Tinman-FP/sovol-sv08-max/c3-4040-gantry/c3/C3_BOM.md

# C3 BOM (AWD 4040 gantry, SV08 Max, INDX, top hat)

## Printed (Qidi Plus 4; PPS-CF unless noted, top hat in ASA)

| Part | Qty | Material | File | Volume cm3 (each) | Mass g (each) | Print size mm |
|---|---|---|---|---|---|---|
| x carriage | 1 | PPS-CF | X_CARRIAGE_PPS-CF.stl | 42.1 | 55 | 80.0 x 39.1 x 88.8 |
| xy joint plate xn | 1 | PPS-CF | XY_JOINT_PLATE_XN_PPS-CF.stl | 30.9 | 40 | 92.5 x 39.0 x 35.0 |
| xy joint plate xp | 1 | PPS-CF | XY_JOINT_PLATE_XP_PPS-CF.stl | 30.9 | 40 | 92.5 x 39.0 x 35.0 |
| xy joint pulley carrier xn | 1 | PPS-CF | XY_JOINT_PULLEY_CARRIER_XN_PPS-CF.stl | 16.4 | 21 | 45.0 x 54.0 x 29.0 |
| xy joint pulley carrier xp | 1 | PPS-CF | XY_JOINT_PULLEY_CARRIER_XP_PPS-CF.stl | 16.4 | 21 | 45.0 x 54.0 x 29.0 |
| rear corner xn motor mount | 1 | PPS-CF | REAR_CORNER_XN_MOTOR_MOUNT_PPS-CF.stl | 55.5 | 72 | 128.0 x 70.0 x 41.0 |
| rear corner xn bearing cap | 1 | PPS-CF | REAR_CORNER_XN_BEARING_CAP_PPS-CF.stl | 36.8 | 48 | 113.0 x 49.6 x 49.0 |
| rear shaft cover xn | 1 | PPS-CF | REAR_SHAFT_COVER_XN_PPS-CF.stl | 2.3 | 3 | 12.0 x 12.0 x 29.0 |
| front corner base xn | 1 | PPS-CF | FRONT_CORNER_BASE_XN_PPS-CF.stl | 17.9 | 23 | 65.0 x 56.0 x 24.8 |
| front cradle xn | 1 | PPS-CF | FRONT_CRADLE_XN_PPS-CF.stl | 66.7 | 87 | 57.5 x 91.5 x 61.0 |
| front motor slider xn | 1 | PPS-CF | FRONT_MOTOR_SLIDER_XN_PPS-CF.stl | 31.2 | 41 | 57.5 x 49.0 x 82.0 |
| rear corner xp motor mount | 1 | PPS-CF | REAR_CORNER_XP_MOTOR_MOUNT_PPS-CF.stl | 49.8 | 65 | 128.0 x 70.0 x 39.0 |
| rear corner xp bearing cap | 1 | PPS-CF | REAR_CORNER_XP_BEARING_CAP_PPS-CF.stl | 21.9 | 28 | 113.0 x 49.6 x 44.0 |
| rear shaft cover xp | 1 | PPS-CF | REAR_SHAFT_COVER_XP_PPS-CF.stl | 2.8 | 4 | 12.0 x 12.0 x 34.0 |
| front corner base xp | 1 | PPS-CF | FRONT_CORNER_BASE_XP_PPS-CF.stl | 17.9 | 23 | 65.0 x 56.0 x 24.8 |
| front cradle xp | 1 | PPS-CF | FRONT_CRADLE_XP_PPS-CF.stl | 66.7 | 87 | 57.5 x 91.5 x 61.0 |
| front motor slider xp | 1 | PPS-CF | FRONT_MOTOR_SLIDER_XP_PPS-CF.stl | 28.7 | 37 | 57.5 x 49.0 x 82.0 |
| camera mount front right | 1 | PPS-CF | CAMERA_MOUNT_FRONT_RIGHT_PPS-CF.stl | 8.9 | 12 | 52.4 x 48.8 x 52.4 |
| top hat corner front right display | 1 | ASA | TOP_HAT_CORNER_FRONT_RIGHT_DISPLAY_ASA.stl | 572.8 | 613 | 225.0 x 225.0 x 195.0 |
| top hat corner front left | 1 | ASA | TOP_HAT_CORNER_FRONT_LEFT_ASA.stl | 411.0 | 440 | 210.0 x 210.0 x 195.0 |
| top hat corner rear right | 1 | ASA | TOP_HAT_CORNER_REAR_RIGHT_ASA.stl | 411.0 | 440 | 210.0 x 210.0 x 195.0 |
| top hat corner rear left | 1 | ASA | TOP_HAT_CORNER_REAR_LEFT_ASA.stl | 411.0 | 440 | 210.0 x 210.0 x 195.0 |
| top hat front | 1 | ASA | TOP_HAT_FRONT_ASA.stl | 286.9 | 307 | 274.0 x 40.0 x 195.0 |
| top hat rear | 1 | ASA | TOP_HAT_REAR_ASA.stl | 307.2 | 329 | 289.0 x 40.0 x 195.0 |
| top hat side right | 1 | ASA | TOP_HAT_SIDE_RIGHT_ASA.stl | 307.0 | 329 | 40.0 x 262.0 x 195.0 |
| top hat side left | 1 | ASA | TOP_HAT_SIDE_LEFT_ASA.stl | 288.9 | 309 | 40.0 x 277.0 x 195.0 |
| umbilical head saddle | 1 | PPS-CF | UMBILICAL_HEAD_SADDLE_PPS-CF.stl | 7.7 | 10 | 54.8 x 25.5 x 26.0 |
| umbilical roof clamp | 1 | PPS-CF | UMBILICAL_ROOF_CLAMP_PPS-CF.stl | 46.4 | 60 | 64.0 x 64.0 x 64.0 |
| chain bracket motor right | 2 | PPS-CF | CHAIN_BRACKET_MOTOR_RIGHT_PPS-CF.stl | 2.6 | 3 | 30.2 x 14.0 x 9.0 |
| chain bracket motor left | 2 | PPS-CF | CHAIN_BRACKET_MOTOR_LEFT_PPS-CF.stl | 2.6 | 3 | 30.2 x 14.0 x 9.0 |
| chain anchor cable right | 2 | PPS-CF | CHAIN_ANCHOR_CABLE_RIGHT_PPS-CF.stl | 5.6 | 7 | 14.0 x 16.0 x 34.0 |
| chain anchor cable left | 2 | PPS-CF | CHAIN_ANCHOR_CABLE_LEFT_PPS-CF.stl | 5.6 | 7 | 14.0 x 16.0 x 34.0 |
| chain entry cable right | 2 | PPS-CF | CHAIN_ENTRY_CABLE_RIGHT_PPS-CF.stl | 15.6 | 20 | 8.0 x 28.0 x 74.0 |
| chain entry cable left | 2 | PPS-CF | CHAIN_ENTRY_CABLE_LEFT_PPS-CF.stl | 15.6 | 20 | 8.0 x 28.0 x 74.0 |
| station bar clip xn | 1 | PPS-CF | STATION_BAR_CLIP_XN_PPS-CF.stl | 2.5 | 3 | 18.5 x 19.0 x 17.0 |
| station bar clip xp | 1 | PPS-CF | STATION_BAR_CLIP_XP_PPS-CF.stl | 2.5 | 3 | 18.5 x 19.0 x 17.0 |
| wiper station bracket | 5 | PPS-CF | WIPER_STATION_BRACKET_PPS-CF.stl | 5.9 | 8 | 60.0 x 21.0 x 11.0 |
| wiper station slider | 5 | PPS-CF | WIPER_STATION_SLIDER_PPS-CF.stl | 4.0 | 5 | 59.0 x 31.0 x 15.1 |
| purge tray | 1 | PPS-CF | PURGE_TRAY_PPS-CF.stl | 44.2 | 57 | 360.0 x 46.0 x 13.7 |

Printed total: PPS-CF 1025 g, ASA 3207 g

## Purchased

| Item | Qty |
|---|---|
| 4040 slot 8 extrusion, side beams | 2 x 561 mm |
| 4040 slot 8 extrusion, X beam | 1 x 556 mm |
| 4040 slot 8 extrusion, rear beam | 1 x 482 mm |
| 15x15 extrusion (1515), dock rail, ends tapped M3 | 1 x 588 mm |
| MGN12 rail, X | 1 x 552 mm |
| MGN12 rail, Y | 2 x 555 mm |
| MGN12H carriage block | 3 |
| LDO 42STH48-2004MAH(S80) motor, 0.9 deg, 80 mm shaft (owned, set of 4) | 4 |
| Gates 2GT 20T 5 mm bore 12 mm pulley (KB3D G2GT-20-5-12) | 4 |
| Gates 2GT 20T 12 mm toothed idler (KB3D G2GT-I-20-12) | 8 |
| Gates 2GT 12 mm smooth idler (KB3D G2GT-I-S-12), on the axles laid out for 15 mm (c3_idlercheck.py) | 2 |
| 625ZZ bearing (double shear, one per motor) | 4 |
| Gates 2MGT 12 mm open belt (needs 2509 mm each incl. clamp tails) | 2 x 2.6 m minimum |
| Bondtech INDX Smart Head, 5 tools, Link Board, Link cable (owned) | 1 kit |
| Bondtech INDX Tool Dock 1515 with hardware (owned) | 5 |
| Beacon Rev H (owned) | 1 |
| Stock SV08 Max camera, reused on the new mount | 1 |
| iPistBit 7 inch 1024x600 HDMI touch display (owner, Amazon B0CRRB1GFN), about 165 x 125 x 15 mm | 1 |
| Sovol top cover (owned), moved from the frame top to the top hat; drilled at its centre for the umbilical roof clamp | 1 |
| PC4-M10 push-fit coupler (owned: BIQU 20 pack), one per tool in the top hat's right side wall (tap the pads M10 x 1 or let the coupler cut its thread) | 5 |
| PG9 cable gland, top hat rear wall (display and other cables) | 1 |
| Micro cable chain 7 x 7 mm inside, at most 11.5 mm wide outside (it hangs in a 16 mm gap), bend radius 18 mm, one per motor | 4 x 340 mm + end links |
| PTFE tube 4 mm OD x 2 mm ID, one continuous length per tool: filament box -> side-wall coupler -> tool | 5 x 0.98 m inside + the run to the filament box |
| Piano (music) wire 1.4 mm for the umbilical (as the Rat Rig V-Core 4; 1.2 mm sags onto belt B at full height) | 1 x 0.9 m |
| Split loom or braided sleeve 10-13 mm: umbilical (wire, INDX Link cable, Beacon USB) | 1 m |
| INDX Link cable, Link Board (on the top cover) to the head through the umbilical (owned) | 1 (about 0.9 m needed) |
| Beacon USB cable, head to the USB hub on the top cover, through the umbilical | 1 (about 0.9 m needed) |
| M5 slot 8 T-nut + M5 x 10 SHCS (chain brackets) | 4 |
| M3 x 16 SHCS + M3 nut: chain anchors through the side panels (drill 3.4 mm, with the entry plate as the template) | 8 |
| M3 x 8 SHCS: chain end links to their brackets and anchors (check the chain's end-link holes) | 16 |
| M3 x 12 SHCS + washer + nut: umbilical roof clamp through the top cover (drill 4 x 3.4 mm with the clamp as the template, and 16 mm in the middle for the cables) | 4 |
| M3 heat-set insert + M3 x 6 set screw (piano-wire clamps: roof clamp and head saddle) | 2 + 2 |
| VHB tape, for the umbilical saddle on the INDX PCB cover | a strip |
| Link Board and USB hub on top of the cover beside the cable hole (VHB or your own mount) | - |
| Zip ties 2.5 mm (umbilical cables to the wire) | 15 |
| M5 slot 8 T-nut (28 gantry: rear corners 2 x 5, front cradles 2 x 6, XY joints 2 x 3) | 28 |
| M5 heat-set insert (rear idler axles) | 6 |
| M4 heat-set insert (rear caps 4, front cradles 10) | 14 |
| M3 heat-set insert (joints 6, Beacon 2, sliders 2, camera 1, display 4) | 15 |
| M5 aluminium spacer 5.2 ID x 8 OD, below and above each rear idler (lengths in c3/C3_SMOOTH_IDLER_CHECK.json) | 11 pieces |
| M5 aluminium sleeve 5.2 ID x 8 OD, cut so each XY-joint idler sits on its belt level (33 mm between the carrier decks minus the idler width) | 4 |
| M3 x 8 SHCS (MGN12H blocks) | 12 |
| M3 x 10 SHCS + M3 T-nut for 4040 slot 8 (MGN12 rails: X 552 on the X beam, Y 2 x 555 on the side beams; 22 holes per rail at 25 mm pitch, every other hole is acceptable) | 66 + 66 |
| M3 x 10 SHCS (motors 16, joint carriers 6) | 22 |
| M3 x 6 (Beacon) | 2 |
| M3 x 16 SHCS (INDX Smart Head to the X carriage, heads on the back) | 4 |
| M3 x 40 SHCS (front tension screws) | 2 |
| M3 x 12 (dock rail ends) | 2 |
| M3 x 10 (camera pinch screw) | 1 |
| M3 x 16 SHCS + nut (top hat joints) | 16 |
| M4 x 12 SHCS (rear arms) | 4 |
| M4 x 18 SHCS (front arms, through the base wall) | 4 |
| M4 x 35 SHCS (rear bearing caps) | 4 |
| M4 x 12 SHCS + washer (front slider clamps, rear slots) | 4 |
| M4 x 16 SHCS + washer (front slider clamps through the base tongues) | 4 |
| M4 x 25 SHCS (dock bracket to cradle) | 2 |
| M5 x 10 SHCS (beam T-nuts: rear corners 2 x 4, front cradles 2 x 4, XY joints 2 x 3) | 22 |
| M5 x 20 SHCS (cradle bottom slots) | 4 |
| M5 x 12 SHCS (rear outer slots) | 2 |
| M5 x 45 SHCS + nyloc (joint pulley axles) | 4 |
| M5 SHCS for rear idler axles, length to the cap: 3 per corner | 6 |
| Zip ties 2.5 mm (camera) | 2 |
| Qidi Plus 4 / Q2 silicone nozzle wiper, 27 x 15 x 4.7 mm high (Qidi "Plus4 Wiper Silicone Case", 5 pack: 5 pads, one per station; a second pack for spares) | 2 packs |
| High-temperature red RTV silicone (Permatex Hi-Temp Red or similar), glues the pads into the sliders | 1 tube |
| 15x15 extrusion (1515, same profile as the dock rail), station bar, ends plain | 1 x 566 mm |
| 3 mm x 20 mm steel dowel pin (wiper slider guides, pressed into the brackets) | 10 |
| M3 T-nut for 1515 (station brackets 10, bar clips 2) | 12 |
| M3 x 8 SHCS (station brackets to the bar) | 10 |
| M3 x 6 SHCS (bar clips to the bar) | 2 |
| M3 x 8 countersunk FHCS (bar clips to the front cradle webs) | 4 |
| M3 heat-set insert, short (3-4 mm long), front cradle inner webs | 4 |
| M3 x 8 set screw, cup point (wiper rest-height stops, tapped into the bracket lugs) | 10 |
