Tinman-FP/sovol-sv08-max/c3-4040-gantry/c3/C3_Z_BOM.md

# C3 Z upgrade BOM (12 mm belts, 17HM19-2004S1)

## Printed (PPS-CF, Qidi Plus 4, support-free)

| Part | File | Qty | Mass g each | Print size mm |
|---|---|---|---|---|
| z carriage plate A (front right + rear left) | Z_CARRIAGE_PLATE_A_PPS-CF.stl | 2 | 18 | 37.1 x 17.0 x 40.0 |
| z carriage plate B (front left + rear right) | Z_CARRIAGE_PLATE_B_PPS-CF.stl | 2 | 18 | 37.1 x 17.0 x 40.0 |
| z belt clamp cover A (front right + rear left) | Z_BELT_CLAMP_COVER_A_PPS-CF.stl | 2 | 3 | 40.0 x 17.0 x 5.5 |
| z belt clamp cover B (front left + rear right) | Z_BELT_CLAMP_COVER_B_PPS-CF.stl | 2 | 3 | 40.0 x 17.0 x 5.5 |
| z tensioner block 12mm A (front right + rear left) | Z_TENSIONER_BLOCK_12MM_A_PPS-CF.stl | 2 | 4 | 16.4 x 25.0 x 25.0 |
| z tensioner block 12mm B (front left + rear right) | Z_TENSIONER_BLOCK_12MM_B_PPS-CF.stl | 2 | 4 | 16.4 x 25.0 x 25.0 |
| z tensioner seat 12mm A (front right + rear left) | Z_TENSIONER_SEAT_12MM_A_PPS-CF.stl | 2 | 20 | 40.3 x 31.0 x 41.5 |
| z tensioner seat 12mm B (front left + rear right) | Z_TENSIONER_SEAT_12MM_B_PPS-CF.stl | 2 | 20 | 40.3 x 31.0 x 41.5 |
| z motor end support A (front right + rear left) | Z_MOTOR_END_SUPPORT_A_PPS-CF.stl | 2 | 7 | 27.1 x 38.2 x 20.0 |
| z motor end support B (front left + rear right) | Z_MOTOR_END_SUPPORT_B_PPS-CF.stl | 2 | 7 | 27.1 x 38.2 x 20.0 |

Printed total: 208 g

## Purchased

| Item | Qty |
|---|---|
| Gates 2MGT 12 mm open belt, Z (loop 1425 mm around 20T + 20T, plus about 30 mm for the clamp ends) | 4 x 1.5 m (1.6 m for margin) |
| StepperOnline 17HM19-2004S1, 0.9 deg, 48 mm, 24 mm full D-cut shaft (owned) | 4 |
| 20T toothed idler for 12 mm belt, 5 mm bore, flanges <= 16 mm OD, <= 16.4 mm wide (KB3D G2GT-I-20-12 class; check the flange OD) | 4 |
| 20T 2GT drive pulley for 12 mm belt: 6 mm bore, hubless and flangeless, <= 12.6 mm long, M3 grub through the teeth (custom or modified; see README) | 4 |
| MR105ZZ bearing 5 x 10 x 4 (optional motor shaft end support) | 4 |
| M3 x 30 SHCS (end supports: replace the two +X motor screws per motor) | 8 |
| M3 heat-set insert (carriage plate: 2 arm + 1 cover per corner) | 12 |
| M3 x 10 SHCS (clamp covers) | 4 |
| Reused from the stock Z: MGW9H block screws, arm M3 x 20, idler shafts, springs, tension screws, cross shafts, reduction pulleys and loops, 12T pulleys, bottom brackets | - |
