Tinman-FP/sovol-sv08-max/MANIFEST.tsv

path | bytes | sha256
.gitattributes | 389 | 2ef1b32a9d4fc41678ae884d664415558639f10fe6d30f555479917206ab81ef
.gitignore | 169 | f25a15b1db2d95a5c9b7b77f8e677e870c252366815d7d3576e8d7f2c69d4f40
ATTRIBUTION.md | 3145 | 591c9c3a173851e432c3ca48aef1304c8522a2fa7bf57c66346e92acf0921369
CHANGELOG.md | 17101 | 14764aa332e479c224948644b290b488e58e092abe0ab5e26c0ab80fcbc8ac49
LICENSE | 35149 | 3972dc9744f6499f0f9b2dbf76696f2ae7ad8af9b23dde66d6af86c9dfb36986
README.md | 7487 | 5f6943f8d4e4e4222361d5a3c00189d23b79d6b064b4b7e4eeb1294408eefd4d
SAFETY.md | 3225 | 50343dccdd592a632b9d275efedadb1ccbb067e55f77ae84a15cea4772ccb108
c3-4040-gantry/README.md | 41495 | bd2aee0f9b3f2c571b52e47ec6198cae5273e61bf77cee081f8782388542dc61
c3-4040-gantry/c3/C3_BOM.json | 16631 | af99a35d336b5978d05c3169e8341df286434710723af3ec9c59b43785668814
c3-4040-gantry/c3/C3_BOM.md | 10007 | 07b93ad3cba76eb4f2abd1d98299b345afb05d034efec6208c3b8a2474c29449
c3-4040-gantry/c3/C3_BUILD_REPORT.json | 788 | 54ec82404f2f0ae7ce8d228315057fa8171725068d0c3db8e6de6dfcce6c6c71
c3-4040-gantry/c3/C3_CLEARANCE.json | 519 | e56f7b85abca5db46558ae306399f67133736e9d6bc192f665a7a3e5c847fb69
c3-4040-gantry/c3/C3_GANTRY.FCStd | 17378446 | 295d7d2204e3964dda65bc1cd588e4613968248f83bf8fc4d3a731d8af6173aa
c3-4040-gantry/c3/C3_GANTRY.step | 54698921 | 576db9c58519e48c66d1e8f5c1d829d0f77f0caab64e2da424632aae16ad7a4c
c3-4040-gantry/c3/C3_HARD_STOP_SWEEP.json | 5323 | 202f6855c5d9acedda4ecb51d84691874d539fae0333f1ce2c6bf73d6ec73f45
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
c3-4040-gantry/klipper_c3/slicer/ORCA_MACHINE_GCODE.md | 2202 | 628f547970dbf1375f1886b065f8134426d3aeaf1b24370ffe61b80b343408fc
c3-4040-gantry/klipper_c3/tools/check_config.py | 37808 | 14f1f4ea8551ef98829d725a0bcdf065facf08cf73239d3d269dc4a0d2632ece
