Tinman-FP/sovol-sv08-max/(list of files, cad)

Other CAD files:
c3-4040-gantry/c3/full/SV08_C3_PRINT_ASA.step
c3-4040-gantry/c3/print/TOP_HAT_SIDE_RIGHT_ASA.step
c3-4040-gantry/c3/SV08_MAX_C3_MODIFIED.step
c3-4040-gantry/inputs/stock_printer/SV08_ORIGINAL_STOCK_REFERENCE.FCStd
c3-4040-gantry/inputs/vendor_references/beacon/Beacon_RevH_Assm_Normal.STEP
c3-4040-gantry/inputs/vendor_references/bondtech/INDX_Tool_Dock_Spring_lid_vendor.stl
c3-4040-gantry/c3/C3_PPS-CF_Qidi_Plus4_0.6mm.3mf
c3-4040-gantry/c3/full/SV08_C3_PRINT_PPS-CF.step
c3-4040-gantry/c3/print/UMBILICAL_ROOF_CLAMP_PPS-CF.step
c3-4040-gantry/inputs/vendor_references/bondtech/INDX_Dock_calibration_tool_vendor.stl
c3-4040-gantry/c3/C3_GANTRY.step
c3-4040-gantry/c3/full/SV08_C3_MACHINE.step
c3-4040-gantry/c3/print/CHAIN_BRACKET_MOTOR_RIGHT_PPS-CF.step
c3-4040-gantry/inputs/vendor_references/bondtech/INDX_simplified_1.19.step
c3-4040-gantry/c3/print/TOP_HAT_CORNER_REAR_RIGHT_ASA.step
c3-4040-gantry/inputs/vendor_references/bondtech/INDX_Tool_Dock_1515_Standard_vendor.stl
c3-4040-gantry/c3/print/TOP_HAT_REAR_ASA.step
c3-4040-gantry/inputs/vendor_references/bondtech/INDX_Tool_Dock_Magnet_holder_vendor.stl
c3-4040-gantry/c3/print/CHAIN_ENTRY_CABLE_LEFT_PPS-CF.step
c3-4040-gantry/c3/print/TOP_HAT_CORNER_FRONT_RIGHT_DISPLAY_ASA.step
c3-4040-gantry/c3/print/TOP_HAT_FRONT_ASA.step
c3-4040-gantry/c3/print/CAMERA_MOUNT_FRONT_RIGHT_PPS-CF.step
c3-4040-gantry/c3/print/CHAIN_ENTRY_CABLE_RIGHT_PPS-CF.step
c3-4040-gantry/c3/print/CHAIN_ANCHOR_CABLE_RIGHT_PPS-CF.step
c3-4040-gantry/c3/print/CHAIN_ANCHOR_CABLE_LEFT_PPS-CF.step
c3-4040-gantry/c3/print/TOP_HAT_CORNER_FRONT_LEFT_ASA.step
c3-4040-gantry/c3/print/CHAIN_BRACKET_MOTOR_LEFT_PPS-CF.step
c3-4040-gantry/c3/print/TOP_HAT_CORNER_REAR_LEFT_ASA.step
c3-4040-gantry/c3/print/UMBILICAL_HEAD_SADDLE_PPS-CF.step
c3-4040-gantry/c3/print/TOP_HAT_SIDE_LEFT_ASA.step
c3-4040-gantry/c3/print/WIPER_STATION_SLIDER_PPS-CF.step
c3-4040-gantry/c3/print/PURGE_TRAY_PPS-CF.step
c3-4040-gantry/c3/print/WIPER_STATION_BRACKET_PPS-CF.step
c3-4040-gantry/c3/print/REAR_CORNER_XN_BEARING_CAP_PPS-CF.step
c3-4040-gantry/c3/print/X_CARRIAGE_PPS-CF.step
c3-4040-gantry/c3/print/XY_JOINT_PLATE_XN_PPS-CF.step
c3-4040-gantry/c3/print/Z_TENSIONER_BLOCK_12MM_B_PPS-CF.step
c3-4040-gantry/c3/print/Z_BELT_CLAMP_COVER_A_PPS-CF.step
c3-4040-gantry/c3/print/FRONT_CRADLE_XN_PPS-CF.step
c3-4040-gantry/c3/print/Z_MOTOR_END_SUPPORT_B_PPS-CF.step
c3-4040-gantry/c3/print/Z_TENSIONER_BLOCK_12MM_A_PPS-CF.step
c3-4040-gantry/c3/print/REAR_SHAFT_COVER_XP_PPS-CF.step
c3-4040-gantry/c3/print/REAR_CORNER_XN_MOTOR_MOUNT_PPS-CF.step
c3-4040-gantry/c3/print/Z_CARRIAGE_PLATE_A_PPS-CF.step
c3-4040-gantry/c3/print/STATION_BAR_CLIP_XP_PPS-CF.step
c3-4040-gantry/c3/print/Z_TENSIONER_SEAT_12MM_B_PPS-CF.step
c3-4040-gantry/c3/print/XY_JOINT_PLATE_XP_PPS-CF.step
c3-4040-gantry/c3/print/REAR_CORNER_XP_MOTOR_MOUNT_PPS-CF.step
c3-4040-gantry/c3/print/Z_TENSIONER_SEAT_12MM_A_PPS-CF.step
c3-4040-gantry/c3/print/FRONT_CRADLE_XP_PPS-CF.step
c3-4040-gantry/c3/print/REAR_CORNER_XP_BEARING_CAP_PPS-CF.step
c3-4040-gantry/c3/print/REAR_SHAFT_COVER_XN_PPS-CF.step
c3-4040-gantry/c3/print/Z_MOTOR_END_SUPPORT_A_PPS-CF.step
c3-4040-gantry/c3/print/FRONT_MOTOR_SLIDER_XN_PPS-CF.step
c3-4040-gantry/c3/print/STATION_BAR_CLIP_XN_PPS-CF.step
c3-4040-gantry/c3/print/FRONT_CORNER_BASE_XN_PPS-CF.step
c3-4040-gantry/c3/print/XY_JOINT_PULLEY_CARRIER_XP_PPS-CF.step
c3-4040-gantry/c3/print/XY_JOINT_PULLEY_CARRIER_XN_PPS-CF.step
c3-4040-gantry/c3/print/FRONT_MOTOR_SLIDER_XP_PPS-CF.step
c3-4040-gantry/c3/print/Z_BELT_CLAMP_COVER_B_PPS-CF.step
c3-4040-gantry/c3/print/Z_CARRIAGE_PLATE_B_PPS-CF.step
c3-4040-gantry/c3/print/FRONT_CORNER_BASE_XP_PPS-CF.step
c3-4040-gantry/c3/C3_GANTRY.FCStd
c3-4040-gantry/c3/print/CAMERA_MOUNT_FRONT_RIGHT_PPS-CF.stl
c3-4040-gantry/c3/print/CHAIN_ANCHOR_CABLE_LEFT_PPS-CF.stl
c3-4040-gantry/c3/print/CHAIN_ANCHOR_CABLE_RIGHT_PPS-CF.stl
c3-4040-gantry/c3/print/CHAIN_BRACKET_MOTOR_LEFT_PPS-CF.stl
c3-4040-gantry/c3/print/CHAIN_BRACKET_MOTOR_RIGHT_PPS-CF.stl
c3-4040-gantry/c3/print/CHAIN_ENTRY_CABLE_LEFT_PPS-CF.stl
c3-4040-gantry/c3/print/CHAIN_ENTRY_CABLE_RIGHT_PPS-CF.stl
c3-4040-gantry/c3/print/FRONT_CORNER_BASE_XN_PPS-CF.stl
c3-4040-gantry/c3/print/FRONT_CORNER_BASE_XP_PPS-CF.stl
c3-4040-gantry/c3/print/FRONT_CRADLE_XN_PPS-CF.stl
c3-4040-gantry/c3/print/FRONT_CRADLE_XP_PPS-CF.stl
c3-4040-gantry/c3/print/FRONT_MOTOR_SLIDER_XN_PPS-CF.stl
c3-4040-gantry/c3/print/FRONT_MOTOR_SLIDER_XP_PPS-CF.stl
c3-4040-gantry/c3/print/PURGE_TRAY_PPS-CF.stl
c3-4040-gantry/c3/print/REAR_CORNER_XN_BEARING_CAP_PPS-CF.stl
c3-4040-gantry/c3/print/REAR_CORNER_XN_MOTOR_MOUNT_PPS-CF.stl
c3-4040-gantry/c3/print/REAR_CORNER_XP_BEARING_CAP_PPS-CF.stl
c3-4040-gantry/c3/print/REAR_CORNER_XP_MOTOR_MOUNT_PPS-CF.stl
c3-4040-gantry/c3/print/REAR_SHAFT_COVER_XN_PPS-CF.stl
c3-4040-gantry/c3/print/REAR_SHAFT_COVER_XP_PPS-CF.stl
c3-4040-gantry/c3/print/STATION_BAR_CLIP_XN_PPS-CF.stl
c3-4040-gantry/c3/print/STATION_BAR_CLIP_XP_PPS-CF.stl
c3-4040-gantry/c3/print/TOP_HAT_CORNER_FRONT_LEFT_ASA.stl
c3-4040-gantry/c3/print/TOP_HAT_CORNER_FRONT_RIGHT_DISPLAY_ASA.stl
c3-4040-gantry/c3/print/TOP_HAT_CORNER_REAR_LEFT_ASA.stl
c3-4040-gantry/c3/print/TOP_HAT_CORNER_REAR_RIGHT_ASA.stl
c3-4040-gantry/c3/print/TOP_HAT_FRONT_ASA.stl
c3-4040-gantry/c3/print/TOP_HAT_REAR_ASA.stl
c3-4040-gantry/c3/print/TOP_HAT_SIDE_LEFT_ASA.stl
c3-4040-gantry/c3/print/TOP_HAT_SIDE_RIGHT_ASA.stl
c3-4040-gantry/c3/print/UMBILICAL_HEAD_SADDLE_PPS-CF.stl
c3-4040-gantry/c3/print/UMBILICAL_ROOF_CLAMP_PPS-CF.stl
c3-4040-gantry/c3/print/WIPER_STATION_BRACKET_PPS-CF.stl
c3-4040-gantry/c3/print/WIPER_STATION_SLIDER_PPS-CF.stl
c3-4040-gantry/c3/print/XY_JOINT_PLATE_XN_PPS-CF.stl
c3-4040-gantry/c3/print/XY_JOINT_PLATE_XP_PPS-CF.stl
c3-4040-gantry/c3/print/XY_JOINT_PULLEY_CARRIER_XN_PPS-CF.stl
c3-4040-gantry/c3/print/XY_JOINT_PULLEY_CARRIER_XP_PPS-CF.stl
c3-4040-gantry/c3/print/X_CARRIAGE_PPS-CF.stl
c3-4040-gantry/c3/print/Z_BELT_CLAMP_COVER_A_PPS-CF.stl
c3-4040-gantry/c3/print/Z_BELT_CLAMP_COVER_B_PPS-CF.stl
c3-4040-gantry/c3/print/Z_CARRIAGE_PLATE_A_PPS-CF.stl
c3-4040-gantry/c3/print/Z_CARRIAGE_PLATE_B_PPS-CF.stl
c3-4040-gantry/c3/print/Z_MOTOR_END_SUPPORT_A_PPS-CF.stl
c3-4040-gantry/c3/print/Z_MOTOR_END_SUPPORT_B_PPS-CF.stl
c3-4040-gantry/c3/print/Z_TENSIONER_BLOCK_12MM_A_PPS-CF.stl
c3-4040-gantry/c3/print/Z_TENSIONER_BLOCK_12MM_B_PPS-CF.stl
c3-4040-gantry/c3/print/Z_TENSIONER_SEAT_12MM_A_PPS-CF.stl
c3-4040-gantry/c3/print/Z_TENSIONER_SEAT_12MM_B_PPS-CF.stl
