Tinman-FP/sovol-sv08-max/(commit log)

2026-10-31 Publish the SV08 Max C3 4040 AWD gantry with Bondtech INDX
    C3 design as of 30 Oct 2026, not yet built: printed parts (STEP and
    STL), the PPS-CF print project (3MF), the full colour-coded printer
    model, the gantry model, BOMs and example sources, the assembly guide,
    the Klipper config, the check reports, and the FreeCAD scripts with
    their inputs. GPL-3.0, with third-party files credited in
    ATTRIBUTION.md.
    [Beacon_RevH_Assm_Normal.STEP, C3_GANTRY.FCStd, C3_GANTRY.step, C3_PPS-CF_Qidi_Plus4_0.6mm.3mf, CAMERA_MOUNT_FRONT_RIGHT_PPS-CF.step, CAMERA_MOUNT_FRONT_RIGHT_PPS-CF.stl, FRONT_CORNER_BASE_XN_PPS-CF.step, FRONT_CORNER_BASE_XN_PPS-CF.stl]
2026-10-31 Fit the wiper stations to the Qidi Plus 4 silicone wiper
    The stations now take Qidi's Plus 4 / Q2 nozzle wiper (27 x 15 x 4.7 mm)
    instead of 30 x 12.7 x 3.2 mm pads cut from silicone strip. The pad lies
    27 mm across, its top 1.2 mm above the nozzle tip; the slider pocket is
    2.3 mm longer and 1.5 mm deeper, and the wipe ends 3.5 mm past the pad.
    The lifted slider now reaches 2.3 mm further back, so the slicer's front
    keep-out is nozzle Y > 535.2 (was 537.5): Orca excluded area to Y 30.8,
    station approach Y 33, Beacon mesh from Y 72. Clearance checks are 0 in
    FreeCAD and SolidCraft; the Klipper config check passes.
    Updated: slider print files, BOM, sourcing list, 3MF (62.4 h, 1168 g),
    full c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
    [C3_GANTRY.FCStd, C3_GANTRY.step, C3_PPS-CF_Qidi_Plus4_0.6mm.3mf, MANIFEST.tsv, SV08_C3_PRINT_PPS-CF.step, SV08_MAX_C3_MODIFIED.step, WIPER_STATION_SLIDER_XN_PPS-CF.step, WIPER_STATION_SLIDER_XN_PPS-CF.stl]
2026-10-31 Remove the outdated 30 Oct review renders
    Ten renders from the morning of 30 Oct showed the design before the wiper
    stations and the Y stop pads. Nothing links to them; the assembly guide and
    the full printer model show the current design. Changelog and manifest
    updated (177 files).
    [MANIFEST.tsv]
2026-10-31 Give every tool its own wiper station; one long purge tray
    The docks move to a 78 mm pitch (X -203/-125/-47/31/109) and each tool gets
    its own wiper station 42 mm beside its dock (X -161/-83/-5/73/151). Each
    tool wipes, purges and loads filament only at its own station; wipe strokes
    step toward the tool's own (empty) dock only. c3_lanecheck.py measures the
    lane spacing that sets the row.
    One 360 mm purge tray replaces the trays under the stations. It keeps their
    height (its rim stays under the station brackets at the first layer), sits
    loose on 20 feet and slides out through the door with no fasteners. It
    prints diagonally on its own plate.
    Slicer keep-out: nozzle Y > 535.2 between X -238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
    [C3_GANTRY.FCStd, C3_GANTRY.step, C3_PPS-CF_Qidi_Plus4_0.6mm.3mf, MANIFEST.tsv, PURGE_TRAY_LEFT_PPS-CF.step, PURGE_TRAY_LEFT_PPS-CF.stl, PURGE_TRAY_PPS-CF.step, PURGE_TRAY_PPS-CF.stl]
2026-11-01 Route the PTFE tubes and head cables through weighted loops
    Each INDX tool keeps its own PTFE tube. A loop head at each front corner
    of the top hat anchors the tubes in PC4-M10 couplers; each tube hangs in
    a weighted loop in an ASA tower on the front Z profile and runs inside to
    a guide above its own dock. The Link and Beacon cables share a loop on
    the right. The spring take-up, rear-wall PTFE ports and Sovol's spool
    holder are removed.
    Adds c3_ptfe.py and c3_ptfecheck.py, 16 print files, and updates the BOM,
    guide, full model and docs. c3_release.py now fails if a printed part has
    no print file (the left tower's bottom section was missing).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
    [C3_GANTRY.FCStd, C3_GANTRY.step, C3_PPS-CF_Qidi_Plus4_0.6mm.3mf, CABLE_LOOP_SLED_PPS-CF.step, CABLE_LOOP_SLED_PPS-CF.stl, LINK_BOARD_AND_USB_HUB_TRAY_PPS-CF.step, LINK_BOARD_AND_USB_HUB_TRAY_PPS-CF.stl, MANIFEST.tsv]
2026-11-01 Route the tubes from the sides and the head cables from the back
    The weighted loops are removed. Each PTFE tube now enters through a
    coupler in the side panel at about 290 mm print height, runs in its own
    micro cable chain in the gap beside the side beam, rises in a side mast
    and drops to its tool on a 0.8 mm piano wire (Snapmaker U1 style). The
    Link Board sits on a mast on the rear beam; the Link cable and Beacon USB
    reach the head as a 1.5 mm piano-wire umbilical ending on a saddle over
    the INDX PCB cover (Rat Rig V-Core 4 IDEX style). The board's power and
    USB come up through the left chains. The top hat is 195 mm tall and its
    end ribs are cut back at 45 degrees.
    Adds c3_routing.py, c3_e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
    [C3_GANTRY.FCStd, C3_GANTRY.step, C3_PPS-CF_Qidi_Plus4_0.6mm.3mf, CABLE_LOOP_SLED_PPS-CF.step, CABLE_LOOP_SLED_PPS-CF.stl, CAMERA_MOUNT_FRONT_RIGHT_PPS-CF.step, CAMERA_MOUNT_FRONT_RIGHT_PPS-CF.stl, CHAIN_ANCHOR_CABLE_LEFT_PPS-CF.step]
2026-11-05 Feed the tubes from the right wall and hang the head cables from the cover
    The PTFE chains, side masts, rear mast and piano-wire tube arcs are
    removed. Each PTFE tube now runs as one continuous tube from the
    filament box through a PC4-M10 coupler in the top hat's right side wall
    (about 705 mm above the bed, 34 degrees down) and hangs free to its
    tool. The five couplers sit two to a bay in dock order, so the parked
    tubes lie side by side instead of crossing. The Link cable and Beacon
    USB come straight down from a round-stalked clamp under the centre of
    the top cover, on a 1.4 mm piano-wire umbilical, to the saddle on the
    INDX PCB cover; the Link Board and USB hub sit on the cover. The four
    mo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
    [C3_GANTRY.FCStd, C3_GANTRY.step, C3_PPS-CF_Qidi_Plus4_0.6mm.3mf, CHAIN_ANCHOR_PTFE_LEFT_PPS-CF.step, CHAIN_ANCHOR_PTFE_LEFT_PPS-CF.stl, CHAIN_ANCHOR_PTFE_RIGHT_PPS-CF.step, CHAIN_ANCHOR_PTFE_RIGHT_PPS-CF.stl, CHAIN_BRACKET_POWER_LEFT_PPS-CF.step]
